fitim-halimi/Industrial_Ventilation_Tube_Cleaner/Documentation/Images/Pic1.png

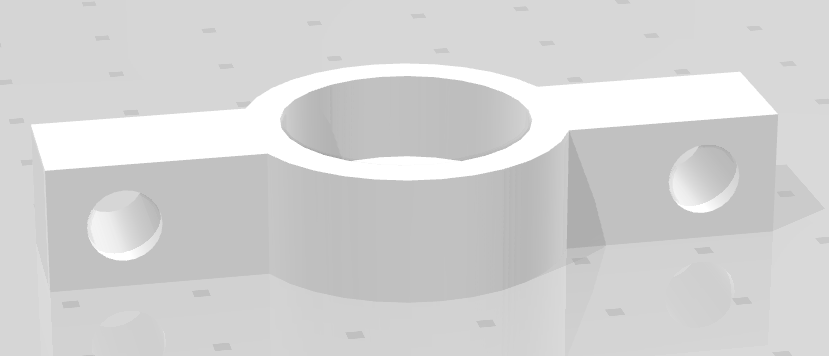
Documentation/Images/Pic1.png
