fitim-halimi/Industrial_Ventilation_Tube_Cleaner/Documentation/Images/Pic3.png

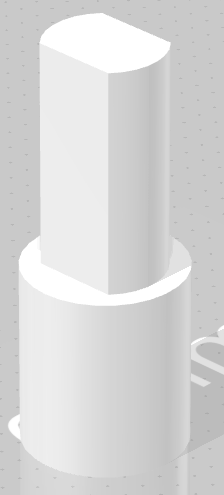
Documentation/Images/Pic3.png
