fitim-halimi/Industrial_Ventilation_Tube_Cleaner/Design of the project/Base of the project/Base_front_part.stl

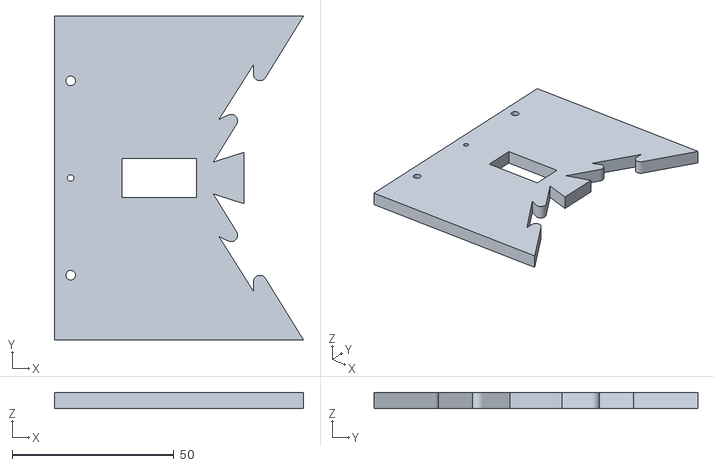
[picture p13: CAD file, 2020-05-02]
Design of the project/Base of the project/Base_front_part.stl
76.9 x 100.0 x 5.00
