fitim-halimi/Industrial_Ventilation_Tube_Cleaner/Design of the project/Electronics holder and note/Reciever_electronic_holder.stl

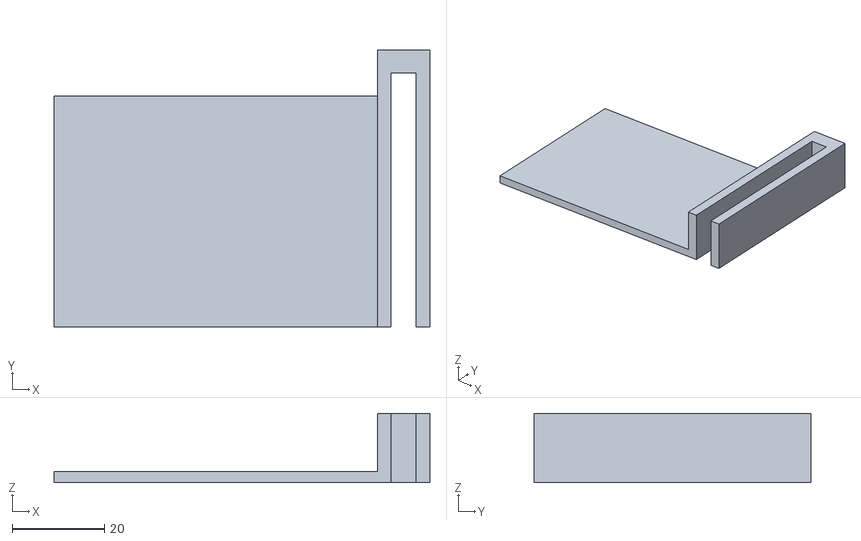
[picture p14: CAD file, 2020-05-03]
Design of the project/Electronics holder and note/Reciever_electronic_holder.stl
81.4 x 60.0 x 15.0
