fitim-halimi/Industrial_Ventilation_Tube_Cleaner/Design of the project/Extender for servo/extender_45_mm.STL

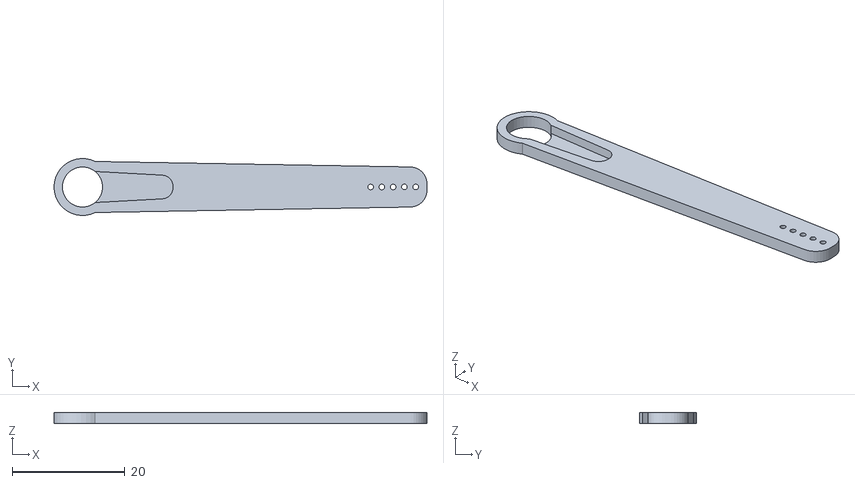
[picture p15: CAD file, 2020-05-17]
Design of the project/Extender for servo/extender_45_mm.STL
66.1 x 10.1 x 2.00
