fitim-halimi/Industrial_Ventilation_Tube_Cleaner/Design of the project/Linear actuator/Suction_head_actuator_connector.stl

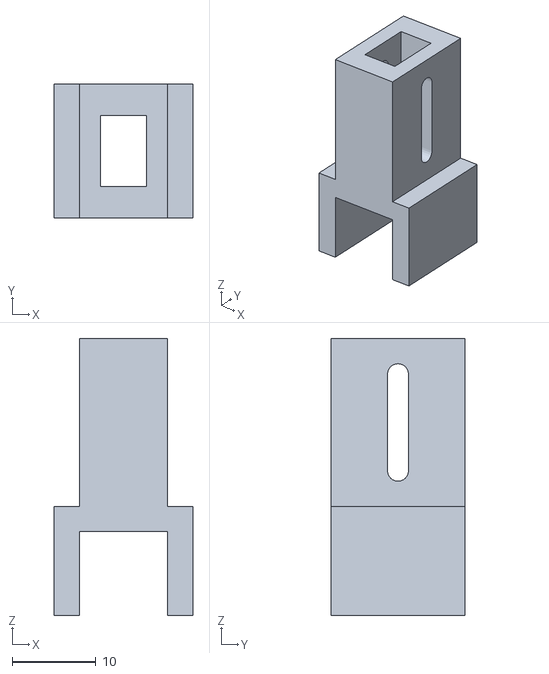
[picture p16: CAD file, 2020-05-21]
Design of the project/Linear actuator/Suction_head_actuator_connector.stl
16.5 x 16.0 x 33.0
