fitim-halimi/Industrial_Ventilation_Tube_Cleaner/Design of the project/Power supply casing/Top_battery_side.stl

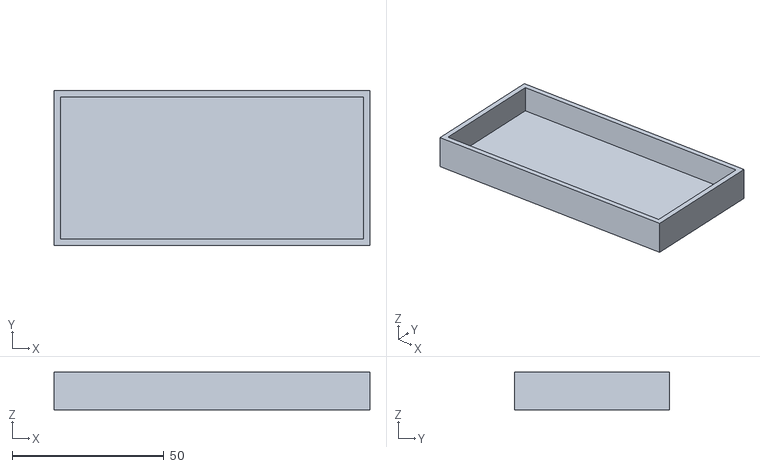
[picture p17: CAD file, 2020-05-15]
Design of the project/Power supply casing/Top_battery_side.stl
104.2 x 51.2 x 12.5
