fitim-halimi/Industrial_Ventilation_Tube_Cleaner/Design of the project/Steering system/BearingCase_connector_2.stl

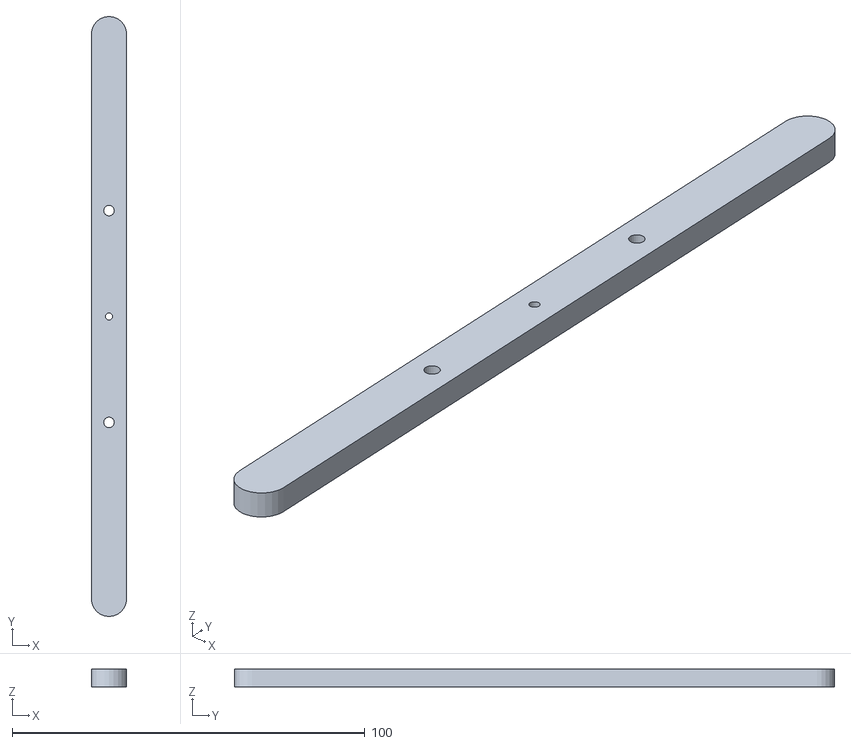
[picture p18: CAD file, 2020-05-15]
Design of the project/Steering system/BearingCase_connector_2.stl
10.0 x 170.0 x 5.00
