fitim-halimi/Industrial_Ventilation_Tube_Cleaner/Design of the project/Vacuum section/Side_connector_Smalll_size_4X.stl

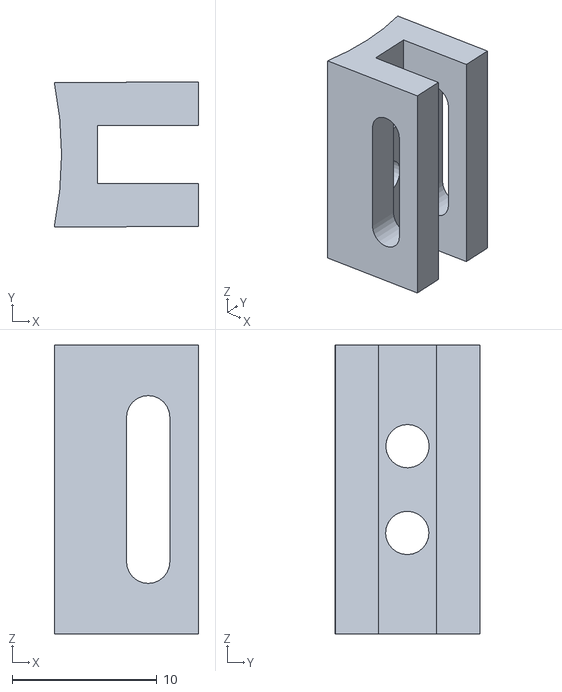
[picture p19: CAD file, 2020-05-21]
Design of the project/Vacuum section/Side_connector_Smalll_size_4X.stl
10.00 x 10.0 x 20.0
