fitim-halimi/Industrial_Ventilation_Tube_Cleaner/Design of the project/Base of the project/Base_first_part.stl

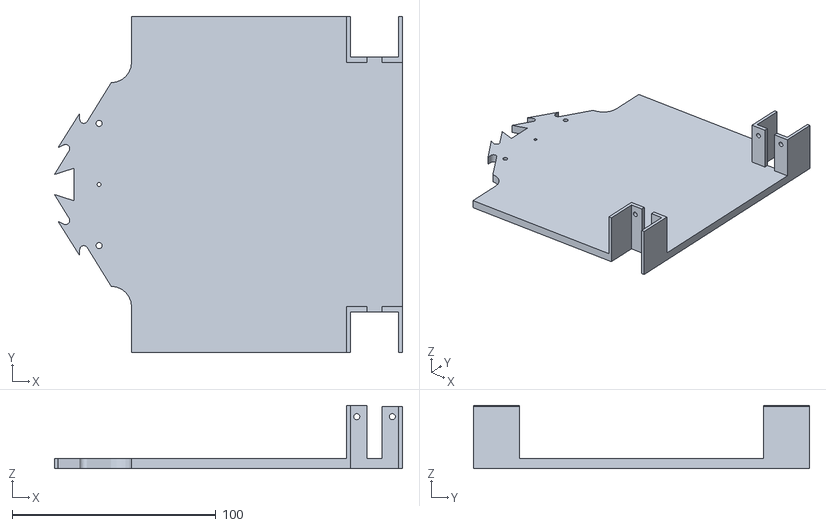
[picture p20: CAD file, 2020-05-02]
Design of the project/Base of the project/Base_first_part.stl
171.0 x 165.0 x 31.0
