fitim-halimi/Industrial_Ventilation_Tube_Cleaner/Design of the project/Electronics holder and note/Author_text_note.stl

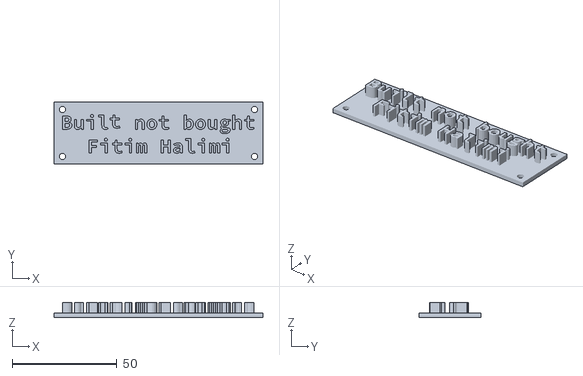
[picture p21: CAD file, 2020-05-03]
Design of the project/Electronics holder and note/Author_text_note.stl
100.0 x 29.8 x 7.00
