fitim-halimi/Industrial_Ventilation_Tube_Cleaner/Design of the project/Extender for servo/extender_50mm.STL

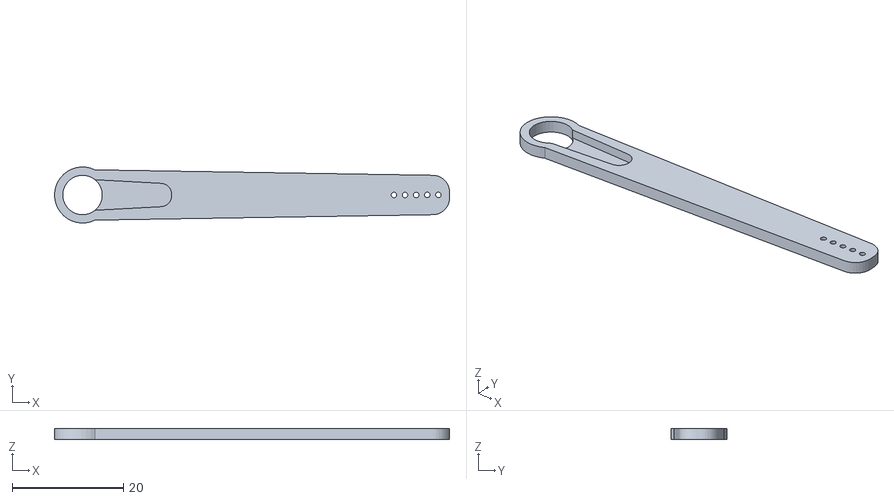
[picture p22: CAD file, 2020-05-15]
Design of the project/Extender for servo/extender_50mm.STL
71.1 x 10.1 x 2.00
