fitim-halimi/Industrial_Ventilation_Tube_Cleaner/Design of the project/Linear actuator/All_components_for_printing.stl

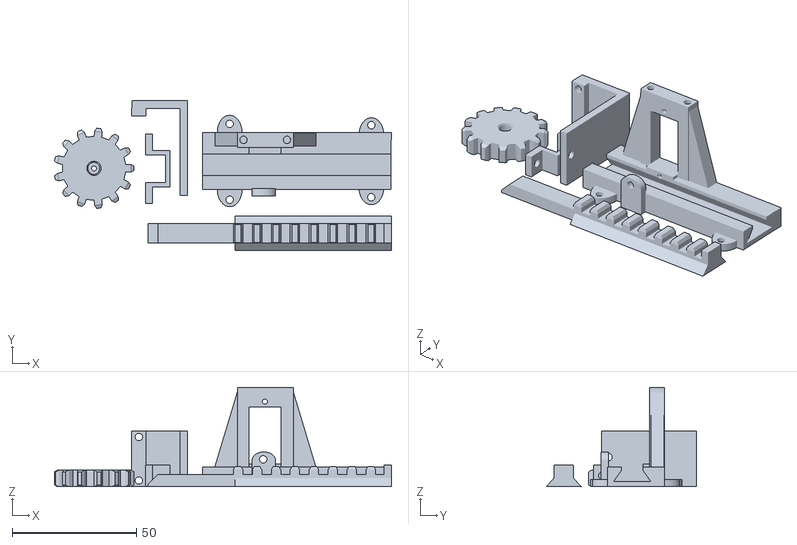
[picture p23: CAD file, 2020-05-21]
Design of the project/Linear actuator/All_components_for_printing.stl
135.6 x 60.5 x 40.0
