fitim-halimi/Industrial_Ventilation_Tube_Cleaner/Design of the project/Power supply casing/Electronics_holder.stl

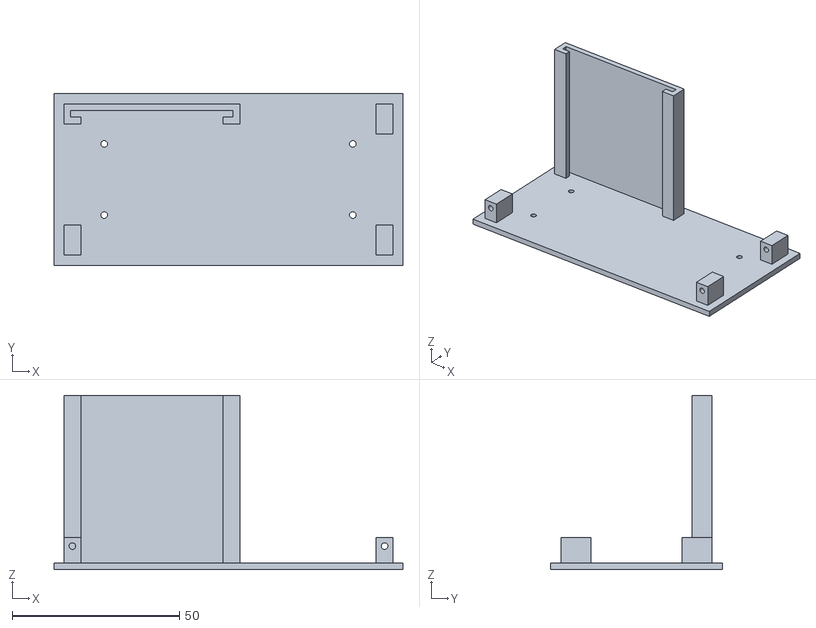
[picture p24: CAD file, 2020-05-06]
Design of the project/Power supply casing/Electronics_holder.stl
104.2 x 51.2 x 52.0
