fitim-halimi/Industrial_Ventilation_Tube_Cleaner/Design of the project/Steering system/BearingCase_connector_1.stl

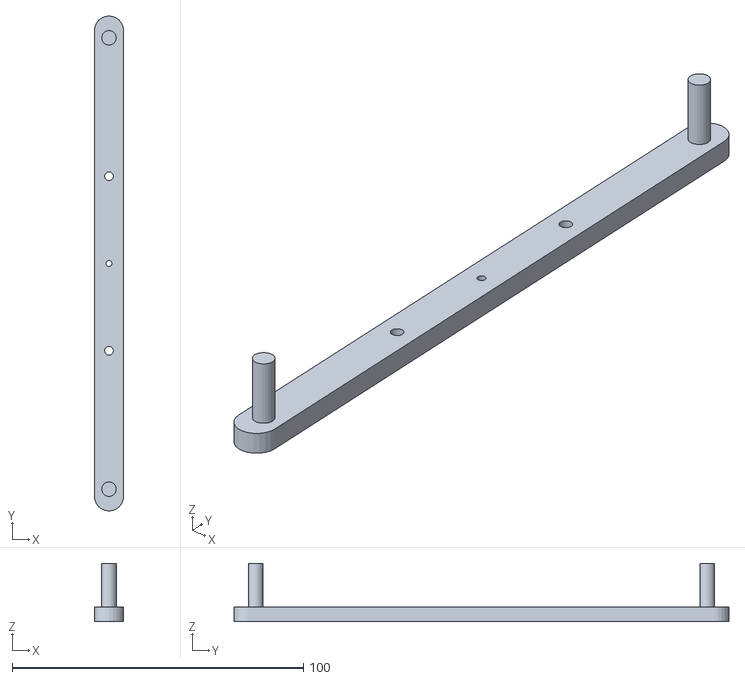
[picture p25: CAD file, 2020-05-15]
Design of the project/Steering system/BearingCase_connector_1.stl
10.0 x 170.0 x 20.0
