fitim-halimi/Industrial_Ventilation_Tube_Cleaner/Design of the project/Vacuum section/Side_connector_Big_Size_3X.stl

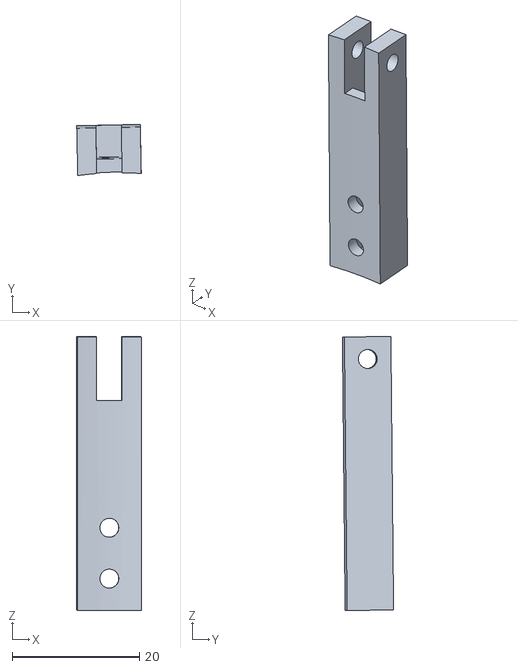
[picture p26: CAD file, 2020-05-21]
Design of the project/Vacuum section/Side_connector_Big_Size_3X.stl
10.1 x 8.05 x 43.1
