fitim-halimi/Industrial_Ventilation_Tube_Cleaner/Design of the project/Extender for servo/extender_40mm.STL

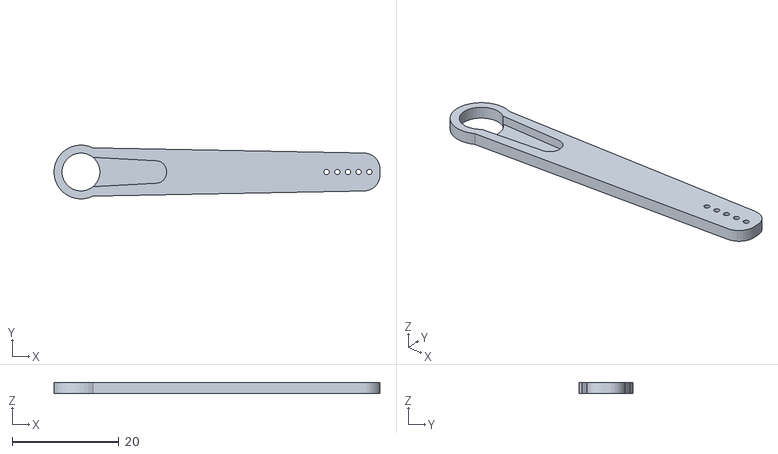
[picture p27: CAD file, 2020-05-15]
Design of the project/Extender for servo/extender_40mm.STL
61.1 x 10.1 x 2.00
