fitim-halimi/Industrial_Ventilation_Tube_Cleaner/Design of the project/Linear actuator/9_Gram_Servo_Actuator_5.stl

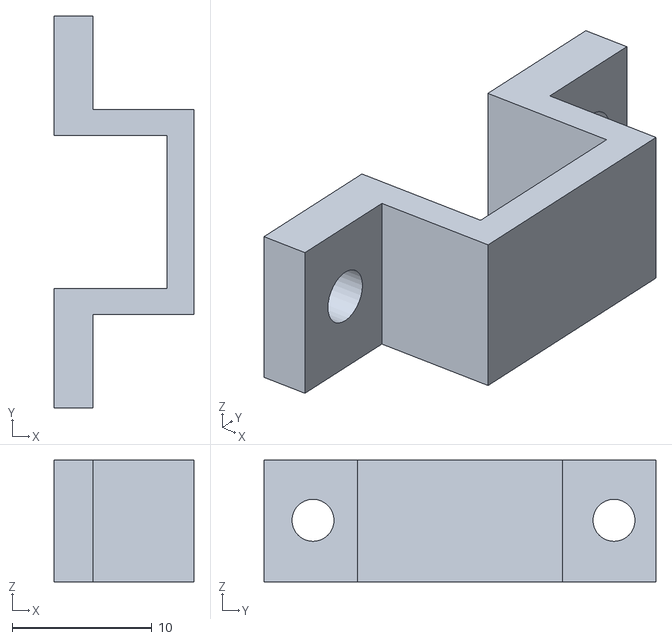
[picture p28: CAD file, 2020-05-21]
Design of the project/Linear actuator/9_Gram_Servo_Actuator_5.stl
10.0 x 28.0 x 8.70
