fitim-halimi/Industrial_Ventilation_Tube_Cleaner/Design of the project/Power supply casing/Electronics_casing.stl

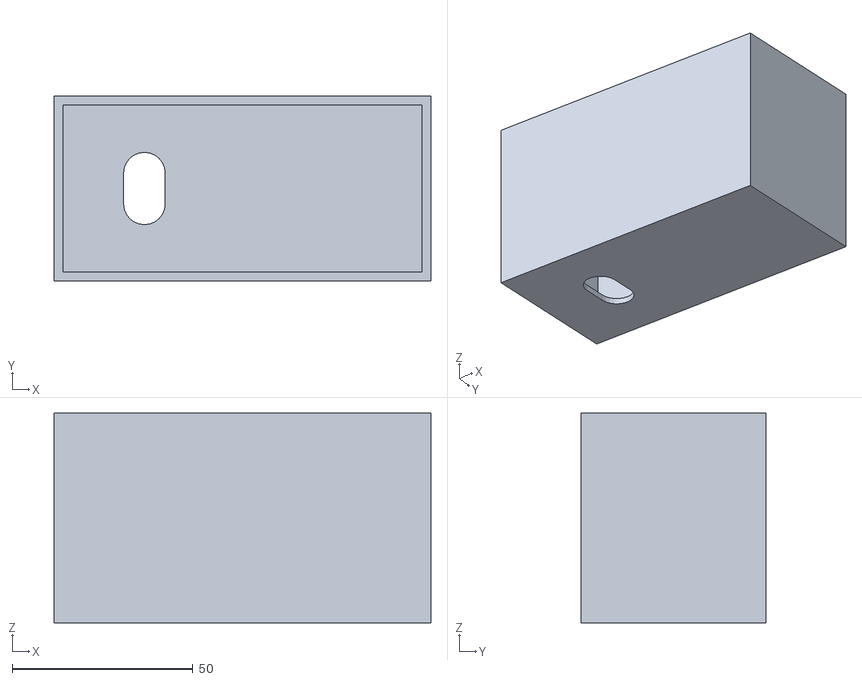
[picture p29: CAD file, 2020-05-05]
Design of the project/Power supply casing/Electronics_casing.stl
104.2 x 51.2 x 58.0
