fitim-halimi/Industrial_Ventilation_Tube_Cleaner/Design of the project/Steering system/Servo_extender_20mm.STL

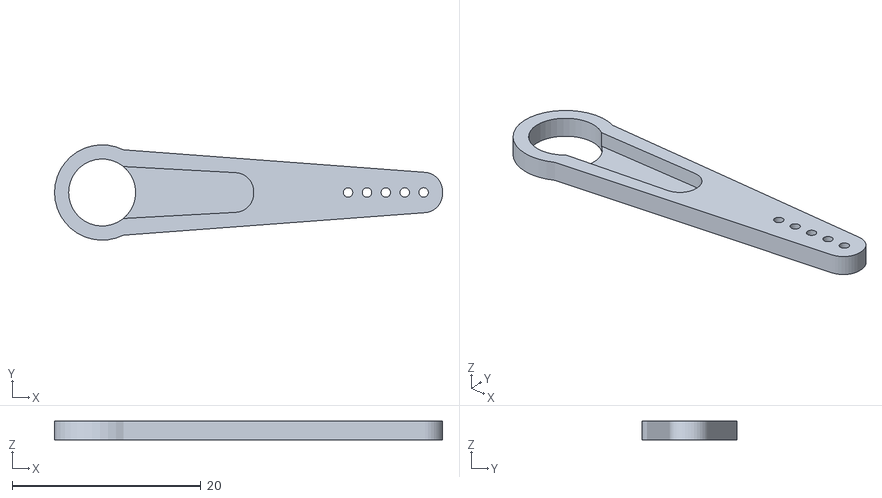
[picture p30: CAD file, 2020-05-06]
Design of the project/Steering system/Servo_extender_20mm.STL
41.1 x 10.1 x 2.00
