fitim-halimi/Industrial_Ventilation_Tube_Cleaner/Design of the project/Vacuum section/Suction_Head.stl

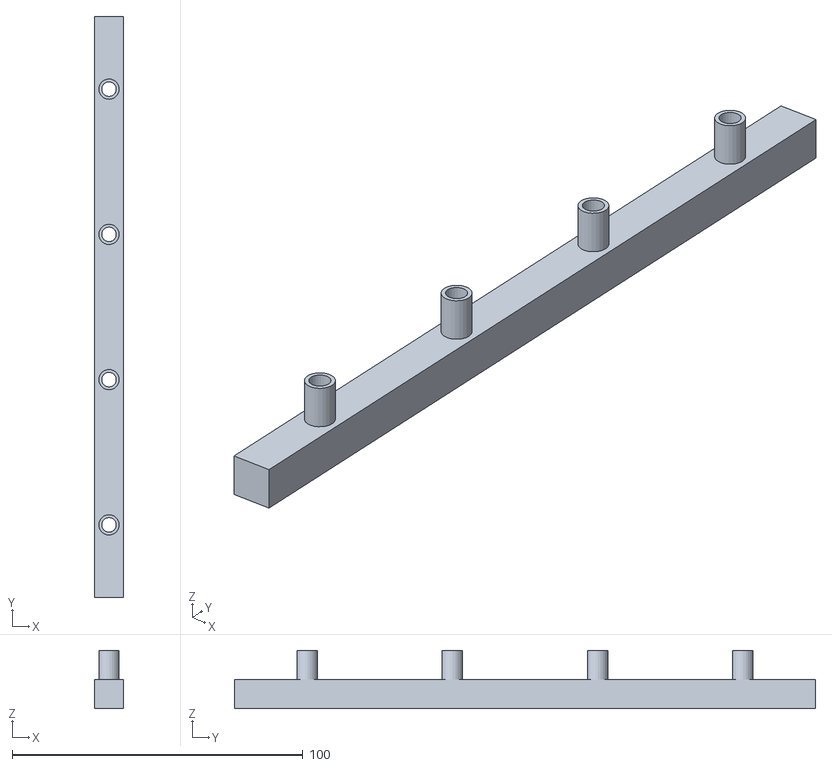
[picture p31: CAD file, 2020-05-21]
Design of the project/Vacuum section/Suction_Head.stl
10.0 x 200.0 x 20.0
