fitim-halimi/Industrial_Ventilation_Tube_Cleaner/Design of the project/Extender for servo/extender_35mm.STL

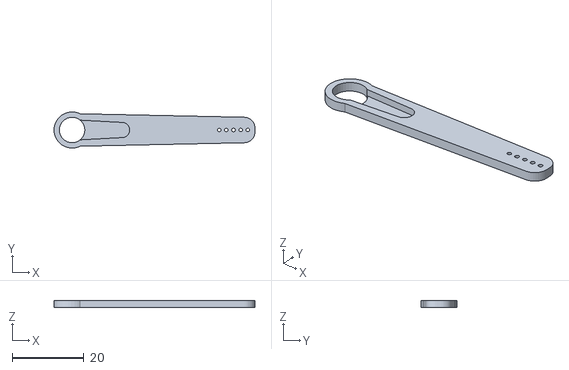
[picture p32: CAD file, 2020-05-15]
Design of the project/Extender for servo/extender_35mm.STL
56.1 x 10.1 x 2.00
