fitim-halimi/Industrial_Ventilation_Tube_Cleaner/Design of the project/Linear actuator/9_Gram_Servo_Actuator_4.stl

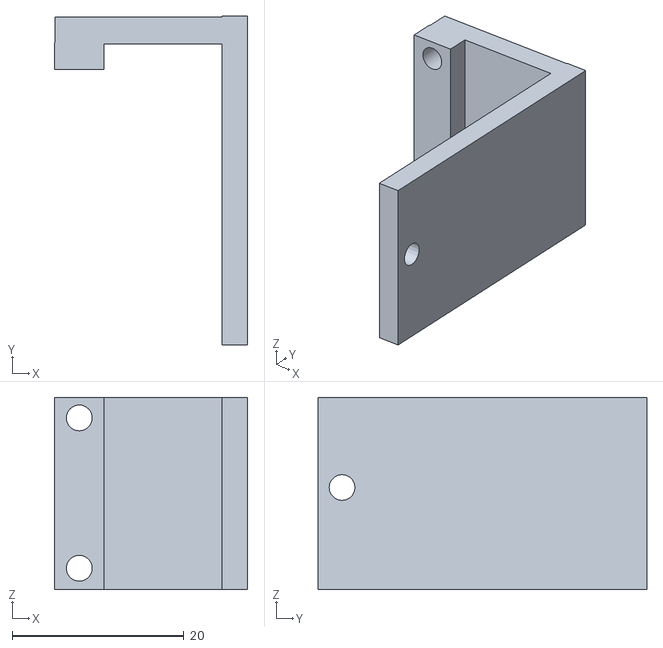
[picture p33: CAD file, 2020-05-17]
Design of the project/Linear actuator/9_Gram_Servo_Actuator_4.stl
22.5 x 38.3 x 22.4
