fitim-halimi/Industrial_Ventilation_Tube_Cleaner/Design of the project/Power supply casing/Bottom_battery_side.stl

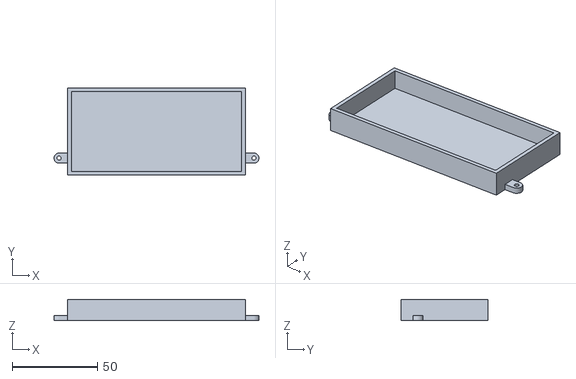
[picture p34: CAD file, 2020-05-03]
Design of the project/Power supply casing/Bottom_battery_side.stl
120.2 x 51.2 x 12.5
