fitim-halimi/Industrial_Ventilation_Tube_Cleaner/Design of the project/Steering system/Bearing_wheel_connector.stl

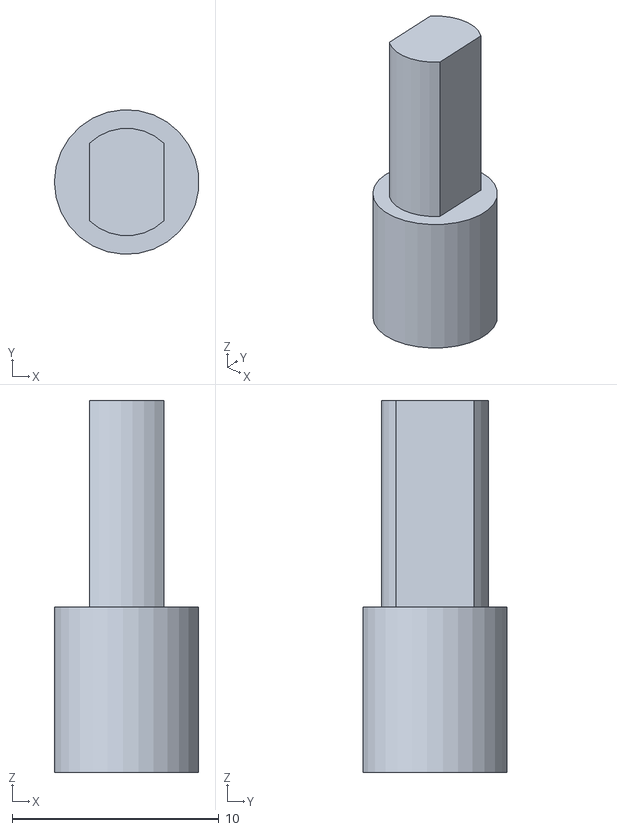
[picture p35: CAD file, 2020-05-05]
Design of the project/Steering system/Bearing_wheel_connector.stl
6.98 x 6.99 x 18.0
