fitim-halimi/Industrial_Ventilation_Tube_Cleaner/Design of the project/Vacuum section/ExtenderTube_filter_adapter.stl

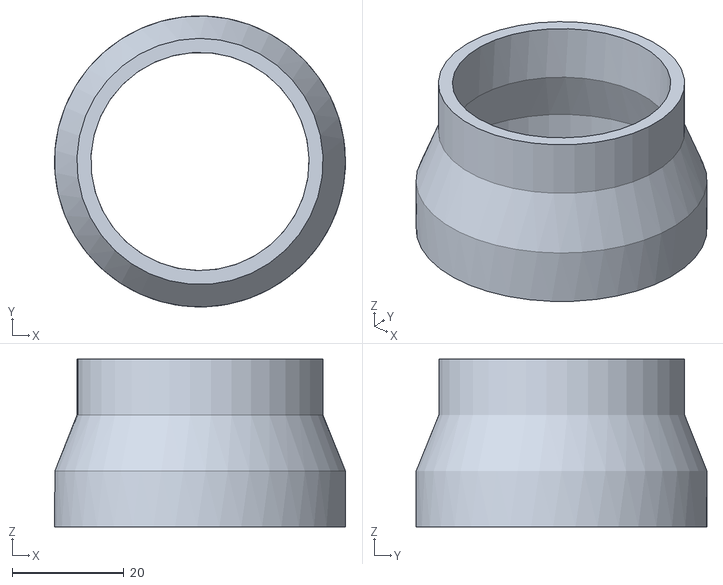
[picture p36: CAD file, 2020-05-17]
Design of the project/Vacuum section/ExtenderTube_filter_adapter.stl
52.0 x 52.0 x 30.0
