fitim-halimi/Industrial_Ventilation_Tube_Cleaner/Design of the project/Extender for servo/extender_15mm.STL

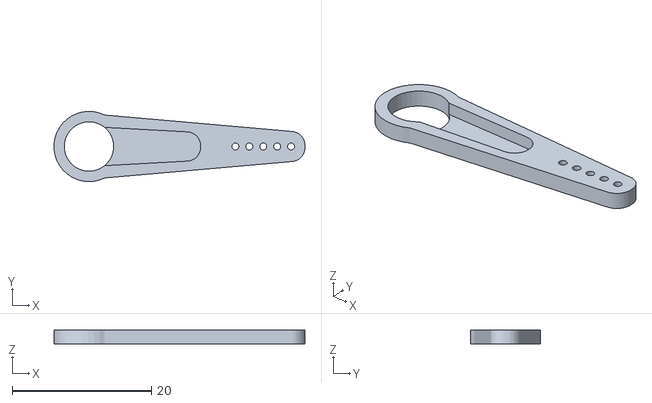
[picture p37: CAD file, 2020-05-05]
Design of the project/Extender for servo/extender_15mm.STL
36.1 x 10.1 x 2.00
