fitim-halimi/Industrial_Ventilation_Tube_Cleaner/Design of the project/Linear actuator/Actuator_holder.stl

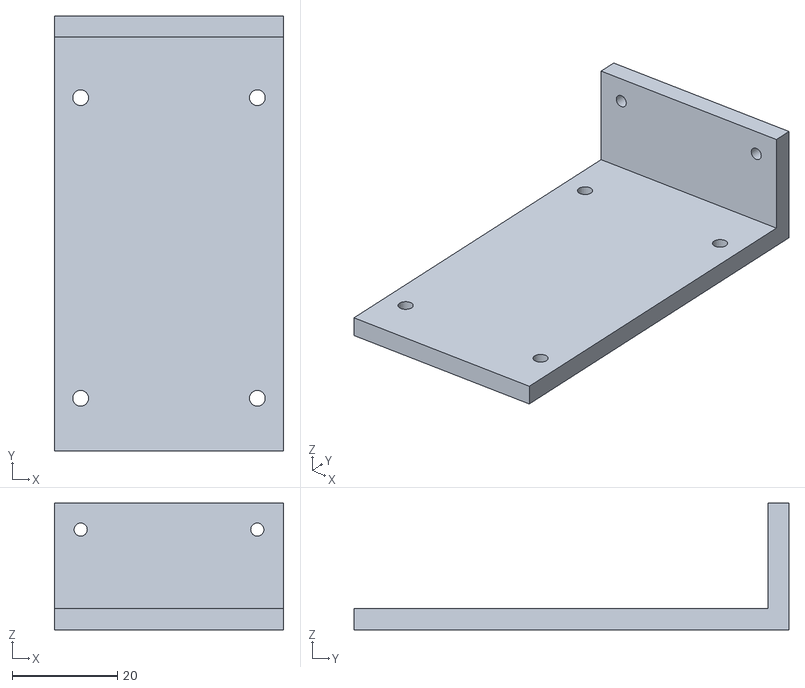
[picture p38: CAD file, 2020-05-15]
Design of the project/Linear actuator/Actuator_holder.stl
43.5 x 82.5 x 24.0
