fitim-halimi/Industrial_Ventilation_Tube_Cleaner/Design of the project/Steering system/Bearing_case.stl

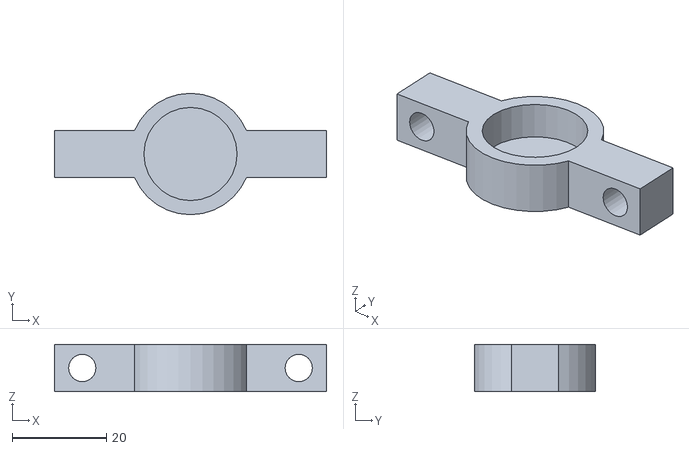
[picture p39: CAD file, 2020-05-03]
Design of the project/Steering system/Bearing_case.stl
57.8 x 25.8 x 10.0
