fitim-halimi/Industrial_Ventilation_Tube_Cleaner/Design of the project/Vacuum section/Vacuum_motor_case.stl

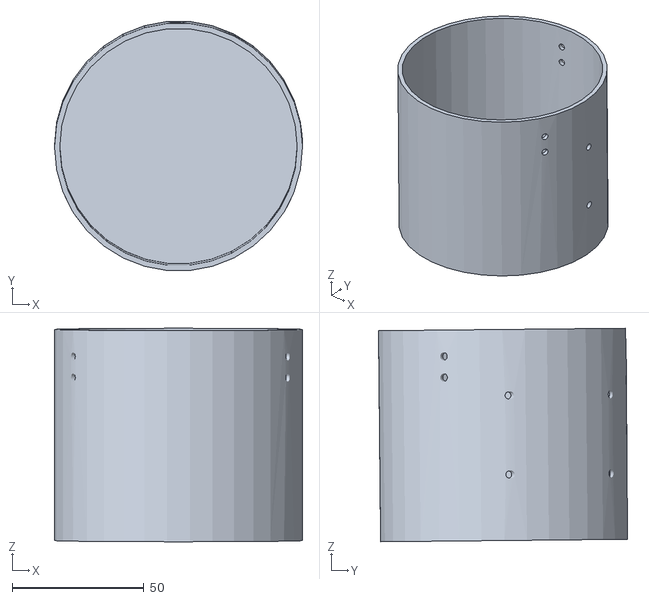
[picture p40: CAD file, 2020-05-15]
Design of the project/Vacuum section/Vacuum_motor_case.stl
94.0 x 94.4 x 80.9
