fitim-halimi/Industrial_Ventilation_Tube_Cleaner/Design of the project/Extender for servo/extender_5mm.STL

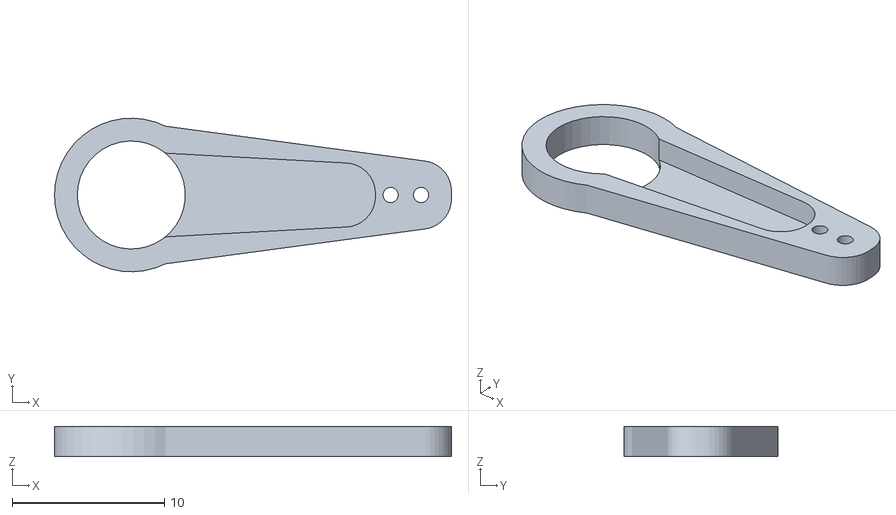
[picture p41: CAD file, 2020-05-03]
Design of the project/Extender for servo/extender_5mm.STL
26.1 x 10.1 x 2.00
