fitim-halimi/Industrial_Ventilation_Tube_Cleaner/Design of the project/Linear actuator/9_Gram_Servo_Actuator_3.stl

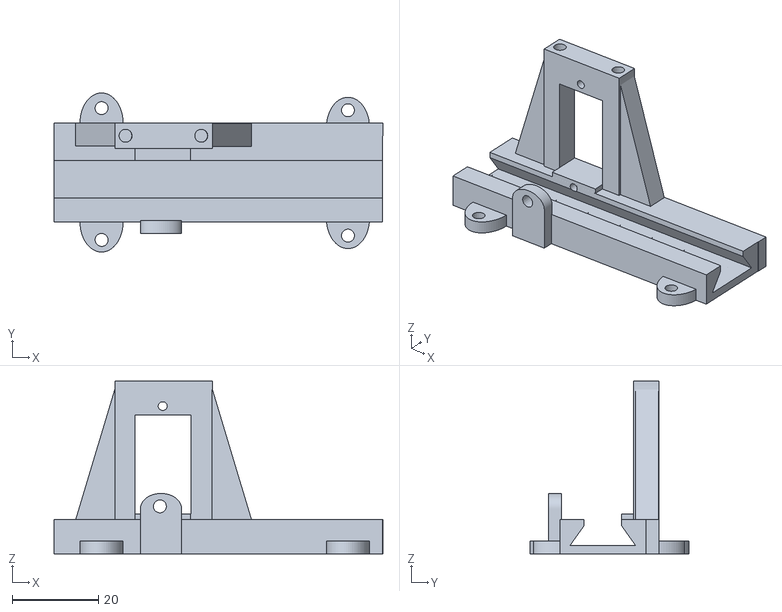
[picture p42: CAD file, 2020-05-15]
Design of the project/Linear actuator/9_Gram_Servo_Actuator_3.stl
76.1 x 36.8 x 40.0
