fitim-halimi/Industrial_Ventilation_Tube_Cleaner/Design of the project/Vacuum section/Extender_tube.stl

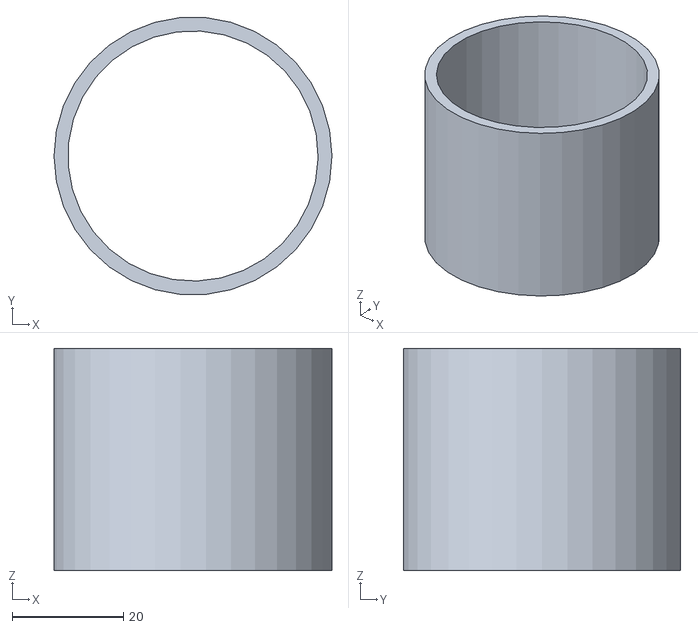
[picture p43: CAD file, 2020-05-15]
Design of the project/Vacuum section/Extender_tube.stl
50.0 x 49.8 x 40.0
