fitim-halimi/Industrial_Ventilation_Tube_Cleaner/Design of the project/Extender for servo/extender_10mm.STL

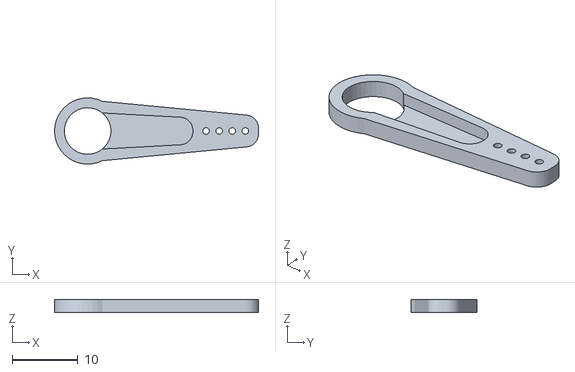
[picture p44: CAD file, 2020-05-03]
Design of the project/Extender for servo/extender_10mm.STL
31.1 x 10.1 x 2.00
