fitim-halimi/Industrial_Ventilation_Tube_Cleaner/Design of the project/Linear actuator/9_Gram_Servo_Actuator_2.stl

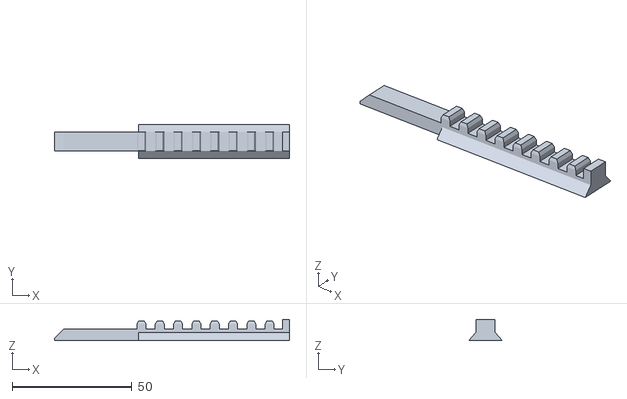
[picture p45: CAD file, 2020-05-05]
Design of the project/Linear actuator/9_Gram_Servo_Actuator_2.stl
98.0 x 14.0 x 8.80
