fitim-halimi/Industrial_Ventilation_Tube_Cleaner/Design of the project/Vacuum section/Vacuum_motor_case_holder.stl

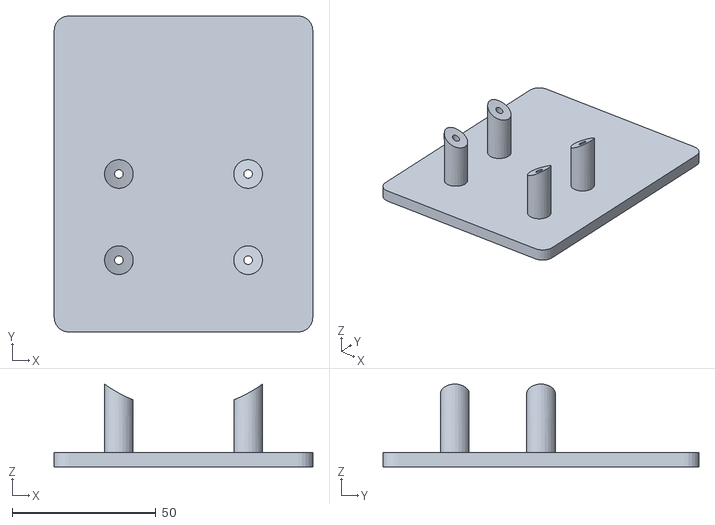
[picture p46: CAD file, 2020-05-06]
Design of the project/Vacuum section/Vacuum_motor_case_holder.stl
90.0 x 110.0 x 28.9
