fitim-halimi/Industrial_Ventilation_Tube_Cleaner/Design of the project/Linear actuator/9_Gram_Servo_Actuator_1.stl

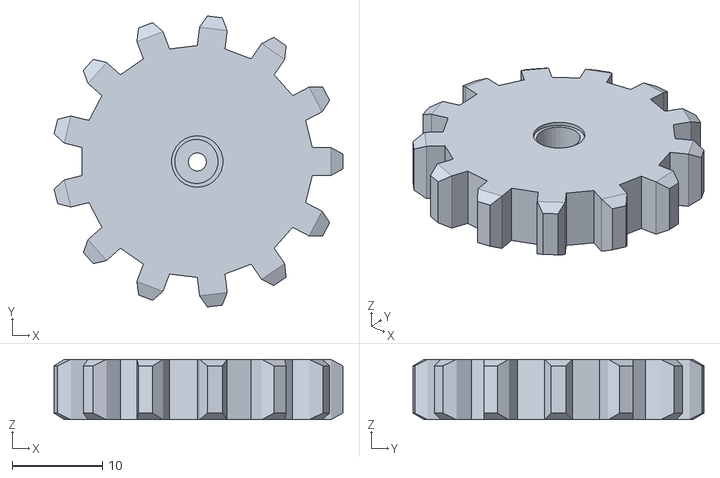
[picture p47: CAD file, 2020-05-03]
Design of the project/Linear actuator/9_Gram_Servo_Actuator_1.stl
32.1 x 32.3 x 6.69
