fitim-halimi/Industrial_Ventilation_Tube_Cleaner/Design of the project/Vacuum section/Connector_3X.stl

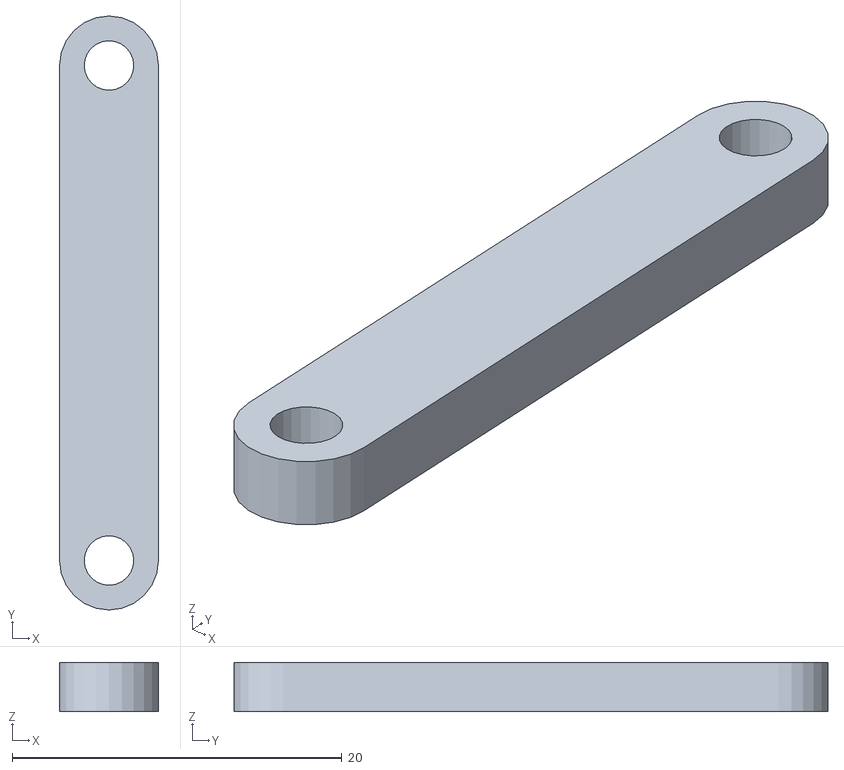
[picture p48: CAD file, 2020-05-03]
Design of the project/Vacuum section/Connector_3X.stl
6.00 x 36.0 x 3.00
